karunstha/waveshare-esp32-1.75-amoled-enclosure/models/esp32_s3_touch_amoled_1_75_right_button.stl

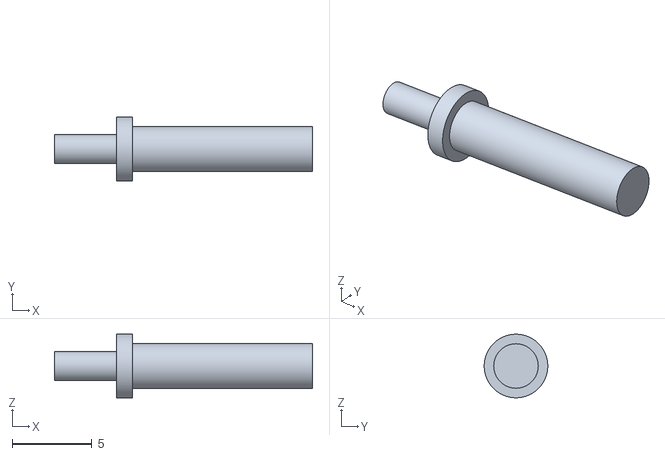
[picture p4: CAD file, 2026-10-31]
models/esp32_s3_touch_amoled_1_75_right_button.stl
16.2 x 4.00 x 4.00
