karunstha/waveshare-esp32-1.75-amoled-enclosure/models/esp32_s3_touch_amoled_1_75_enclosure.stl

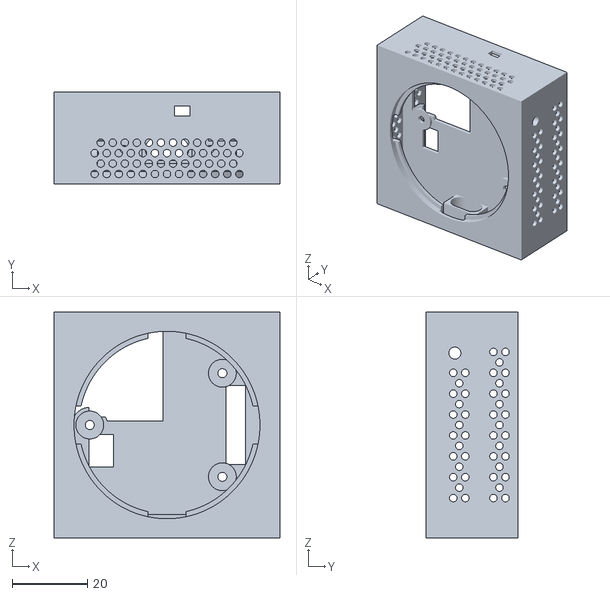
[picture p5: CAD file, 2026-10-31]
models/esp32_s3_touch_amoled_1_75_enclosure.stl
60.0 x 24.3 x 60.0
