karunstha/waveshare-esp32-1.75-amoled-enclosure/models/esp32_s3_touch_amoled_1_75_flush_cover.stl

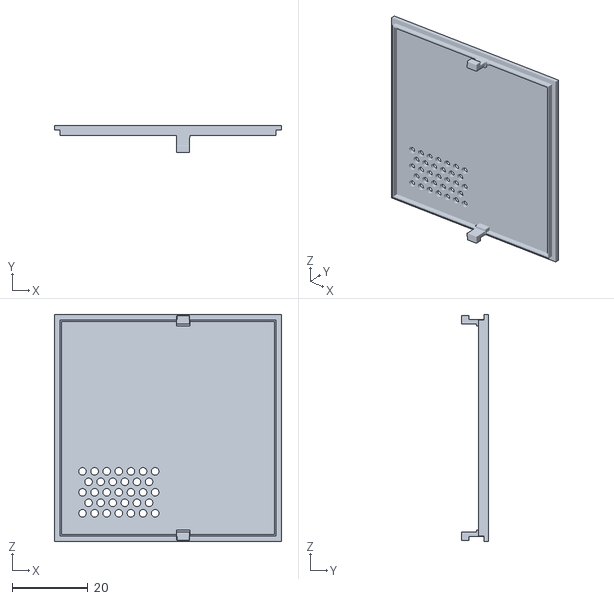
[picture p6: CAD file, 2026-10-30]
models/esp32_s3_touch_amoled_1_75_flush_cover.stl
60.0 x 7.20 x 60.0
