karunstha/waveshare-esp32-1.75-amoled-enclosure/(list of files, cad)

Other CAD files:
models/esp32_s3_touch_amoled_1_75_left_button.stl
