karunstha/waveshare-esp32-1.75-amoled-enclosure/(commit log)

2026-10-29 Update dimensions for PCB opening and USB-C cutout in enclosure design
2026-10-29 Enhance enclosure design with updated dimensions, optional fit-check assembly, and improved mesh handling
2026-10-29 Update screw well depth reduction for improved fit and projection
2026-10-30 Remove compiled Python bytecode file for blender_enclosure
    [ESP32-S3-Touch-AMOLED-1.75-B.dwg, ESP32-S3-Touch-AMOLED-1.75.dwg, ESP32-S3-Touch-AMOLED-1_75.stp]
2026-10-30 Add script to render front and rear previews of the enclosure using Blender
    This script builds the geometry of the enclosure and generates PNG images for both front and rear views. It sets up the Blender scene, camera, and rendering parameters, and saves the output images to a specified directory.
    [esp32_s3_touch_amoled_1_75_enclosure.stl, esp32_s3_touch_amoled_1_75_flush_cover.stl]
2026-10-30 Add scripts for mesh inspection and cover clearance checks
    - Implemented `check_cover_clearance.py` to verify that the assembled cover does not intersect with the main shell, providing bounds and contact face information.
    - Created `inspect_mesh.py` to inspect printable objects for open mesh edges, checking for non-manifold edges and disconnected mesh islands, reporting any failures.
    [esp32_s3_touch_amoled_1_75_enclosure.stl, esp32_s3_touch_amoled_1_75_flush_cover.stl, esp32_s3_touch_amoled_1_75_left_button.stl, esp32_s3_touch_amoled_1_75_right_button.stl]
2026-10-30 Update USB-C and microphone port dimensions for improved alignment and fit
    [esp32_s3_touch_amoled_1_75_enclosure.stl]
2026-10-31 Update button guide positions and adjust switch envelope references for improved fit
    [esp32_s3_touch_amoled_1_75_enclosure copy.stl, esp32_s3_touch_amoled_1_75_enclosure.stl, esp32_s3_touch_amoled_1_75_left_button.stl, esp32_s3_touch_amoled_1_75_right_button.stl]
